elkinleguizamon01/Dise-o-de-Filtros-FIR-en-VHDL/src/gen_muestreo.vhd

--------------------------------------------------------------------------------
-- gen_muestreo.vhd   (S = 64 -> Fs = 320 Hz, DIV_FS = 156250)
-- A partir de UN unico contador genera:
--   fsclk  : pulso de un ciclo de reloj a la frecuencia de muestreo Fs
--   latido : conmuta en cada muestra (Fs/2), sirve para medir Fs
--   pert   : onda cuadrada f_n = Fs/r, r = 4, 8, 16, 32 segun sel
-- 1) Fs/f_n es entero par EXACTO (mismo contador).
-- 2) pert conmuta medio periodo de muestreo ANTES de fsclk.
-- DIV_FS debe ser PAR.
--------------------------------------------------------------------------------
library ieee;
use ieee.std_logic_1164.all;
use ieee.numeric_std.all;

entity gen_muestreo is
    generic (
        DIV_FS : positive := 156250          -- 50 MHz / 320 Hz ; debe ser par
    );
    port (
        clk    : in  std_logic;
        rst    : in  std_logic;              -- reinicio sincrono, activo en alto
        sel    : in  std_logic_vector(1 downto 0);  -- 00:r=4 01:r=8 10:r=16 11:r=32
        fsclk  : out std_logic;
        latido : out std_logic;
        pert   : out std_logic
    );
end entity gen_muestreo;

architecture rtl of gen_muestreo is

    -- muestras que dura cada semiciclo de la perturbacion: r/2
    function semiciclo (s : std_logic_vector(1 downto 0)) return integer is
    begin
        case s is
            when "00"   => return 2;    -- r = 4
            when "01"   => return 4;    -- r = 8
            when "10"   => return 8;    -- r = 16
            when others => return 16;   -- r = 32
        end case;
    end function;

    signal cuenta   : integer range 0 to DIV_FS-1 := 0;
    signal n_semi   : integer range 0 to 15 := 0;
    signal sel_q    : std_logic_vector(1 downto 0) := "00";
    signal pulso    : std_logic := '0';
    signal latido_r : std_logic := '0';
    signal pert_r   : std_logic := '0';

begin

    process (clk)
    begin
        if rising_edge(clk) then
            if rst = '1' then
                cuenta   <= 0;
                n_semi   <= 0;
                pulso    <= '0';
                latido_r <= '0';
                pert_r   <= '0';
                sel_q    <= sel;
            else
                sel_q <= sel;

                if cuenta = DIV_FS-1 then
                    cuenta   <= 0;
                    pulso    <= '1';                 -- instante de muestreo
                    latido_r <= not latido_r;
                else
                    cuenta <= cuenta + 1;
                    pulso  <= '0';

                    -- medio periodo de muestreo antes del proximo pulso
                    if cuenta = DIV_FS/2 - 1 then
                        if n_semi >= semiciclo(sel) - 1 then
                            n_semi <= 0;
                            pert_r <= not pert_r;
                        else
                            n_semi <= n_semi + 1;
                        end if;
                    end if;
                end if;

                -- al cambiar de posicion se reinicia la cuenta de semiciclo
                -- (se evalua en CADA ciclo, no solo en el medio periodo)
                if sel /= sel_q then
                    n_semi <= 0;
                end if;
            end if;
        end if;
    end process;

    fsclk  <= pulso;
    latido <= latido_r;
    pert   <= pert_r;

end architecture rtl;
